MrDemonid/IC-Logic-Tester/Pictures/4a. Start test AP6.jpg

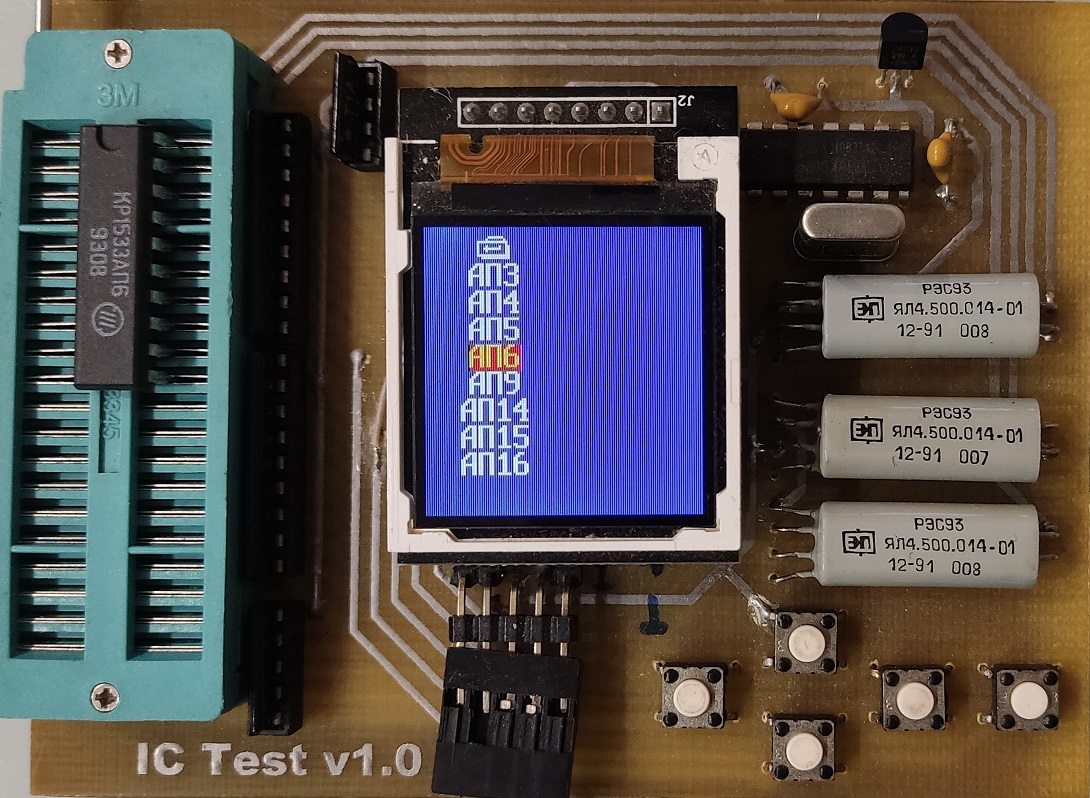
Pictures/4a. Start test AP6.jpg
