MrDemonid/IC-Logic-Tester/Pictures/1. Tester without display.jpg

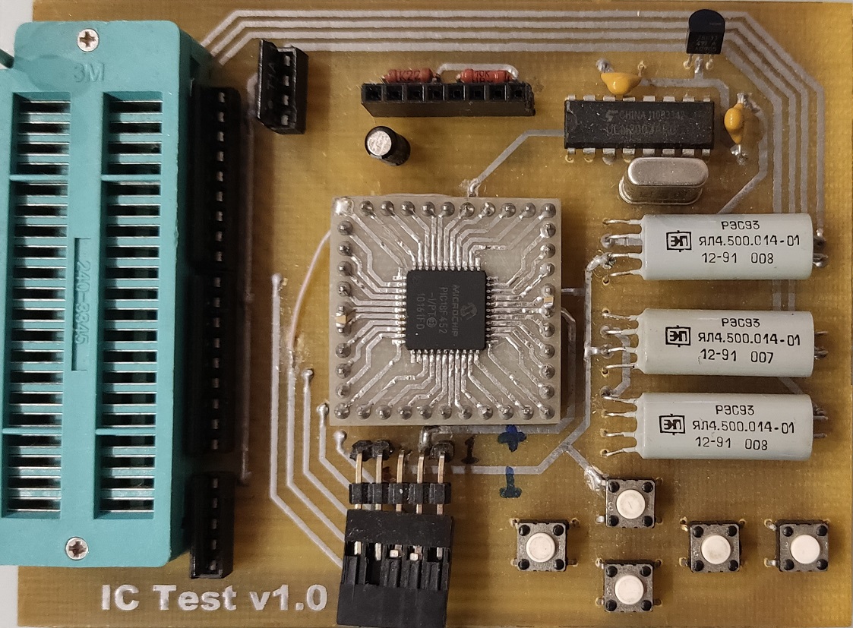
Pictures/1. Tester without display.jpg
