MrDemonid/IC-Logic-Tester/Source/README.TXT

IC tester. Last version.

Протестированные микросхемы:
============================

ТТЛ(Ш)
------
АП3, АП4, АП5, АП6
ИД3, ИД4, ИД7, ИД14
ИЕ2, ИЕ5, ИЕ6, ИЕ7, ИЕ9, ИЕ10, ИЕ18
ИМ3
ИП2, ИП3
ИР9, ИР10, ИР16, ИР22, ИР23, ИР26, ИР27
КП2, КП7, КП11, КП12, КП14, КП15
ЛА1, ЛА2, ЛА3, ЛА4, ЛА6, ЛА7, ЛА8, ЛА13
ЛЕ1, ЛЕ2
ЛИ1, ЛИ3, ЛИ6
ЛЛ1
ЛН1, ЛН3
ЛП5, ЛП8, ЛП11
(!)ЛР1(6), (!)ЛР3(2), ЛР13
РП1 (#)
РУ2
СП1
ТВ1, ТВ9
ТЛ2
ТМ2, ТМ7, ТМ8

----------------------------------------
561
---
ИД1
ИЕ1
ИЕ10
ЛА8
ЛЕ6
ЛИ1
ЛН1
ЛН2
ЛП2
ЛП12
ПР1
ТВ1
ТМ2
ТР2

----------------------------------------
580
---
ВА86  (#)
ИР83  (#)
ИР82

----------------------------------------
589
---
Исключил, поскольку не проходят по току.

===========================================

(!) - выдают ошибки, скорее всего не хватает тока.
(#) - для тестирования требуется к ножке земли микросхемы
      проводком напрямую подключить землю, взяв её, например,
      с 12-го контакта ZIF-панельки (как на фотках).
