MrDemonid/IC-Logic-Tester/Source/NEW/README.TXT

Не успел протестировать, потребность отпала.
