MrDemonid/IC-Logic-Tester/Source/TOOLS/README.TXT

Набор утилит, используемый при создании прошивки тестера.

CUTFNT.
        Конвертация стандартных битовых фонтов 8x8, 8x14 и 8x16 в более 
подходящий формат для микроконтроллера. Запуск без параметров выдаст справку. 
Программа использует функции DOS для выделения и работы с большими блоками 
памяти (200+ Кб), так что не уверен на счет её работы в DosBox. 
В данном случае эта фишка не нужна, просто скорее всего исходник писался на 
основе другого, использующего виртуальный буфер экрана 640x400. За
давностью лет уже не помню, тем более исходники игры безвозвратно утрачены
вместе с дискетой.

ICPARSER.
        Парсит IC-файлы для тестера на AtMega128, товарища Trol'a, и 
конвертирует их под PIC, заодно создавая структуры для меню. Если бы не
его файлы, тестер поддерживал бы очень ограниченный набор микросхем, под
которые он собственно и создавался. 
Сам тестер расположен здесь: https://trolsoft.ru/ru/sch/chip-tester
Парсер писался еще под старую его версию, с монохромных дисплеем, 
когда в нём еще не было даже поддержки DRAM и ПЗУ. Так что
с новыми файлами возможно и не будет работать, не проверял.

LCD.
        Программа на Borland C 3.1, используемая для написания интерфейса.
Отлаживать графически интерфейс прямо на микроконтроллере не очень хорошая 
идея, особенно на старых PIC, где заливка прошивки занимала приличное время,
а ресурс микроконтроллера снижался. Поэтому, графическую часть для МК я всегда
делаю на компьютере, в своеобразном "эмуляторе". А поскольку заморачитваться с 
WIN GUI не хочется, предпочитаю делать это в старом-добром DOS, где работа
с графикой легка и понятна, а самое главное - если программа глючит, то 
это не списать, по привычке, на товарища Билла и его форточки, а нужно искать 
ошибку у себя :)
