MrDemonid/IC-Logic-Tester/Pictures/2. Side back.jpg

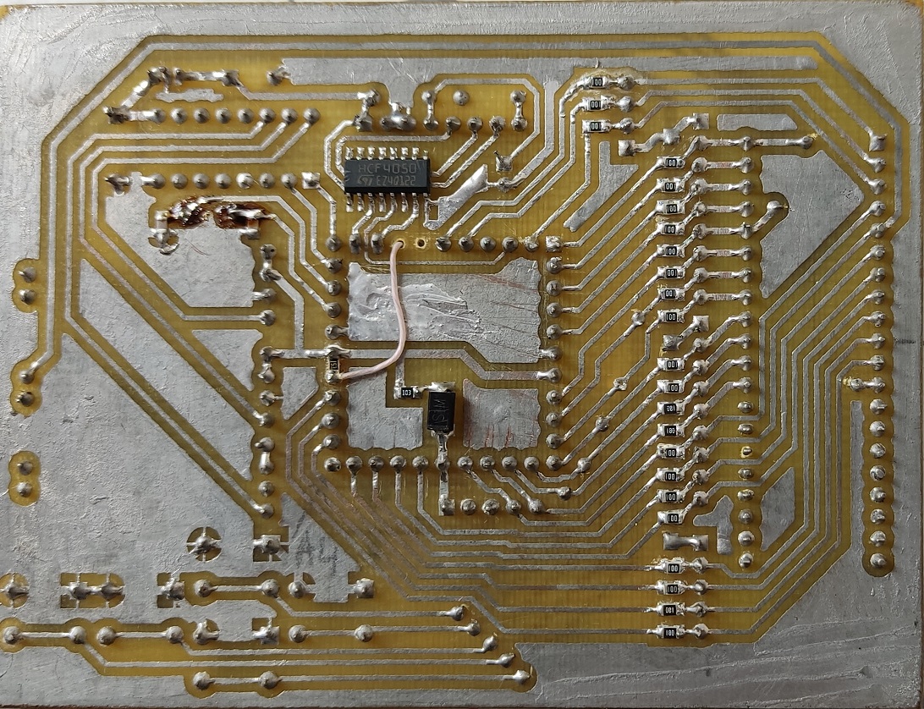
Pictures/2. Side back.jpg
