MrDemonid/IC-Logic-Tester/Pictures/3. Ready.jpg

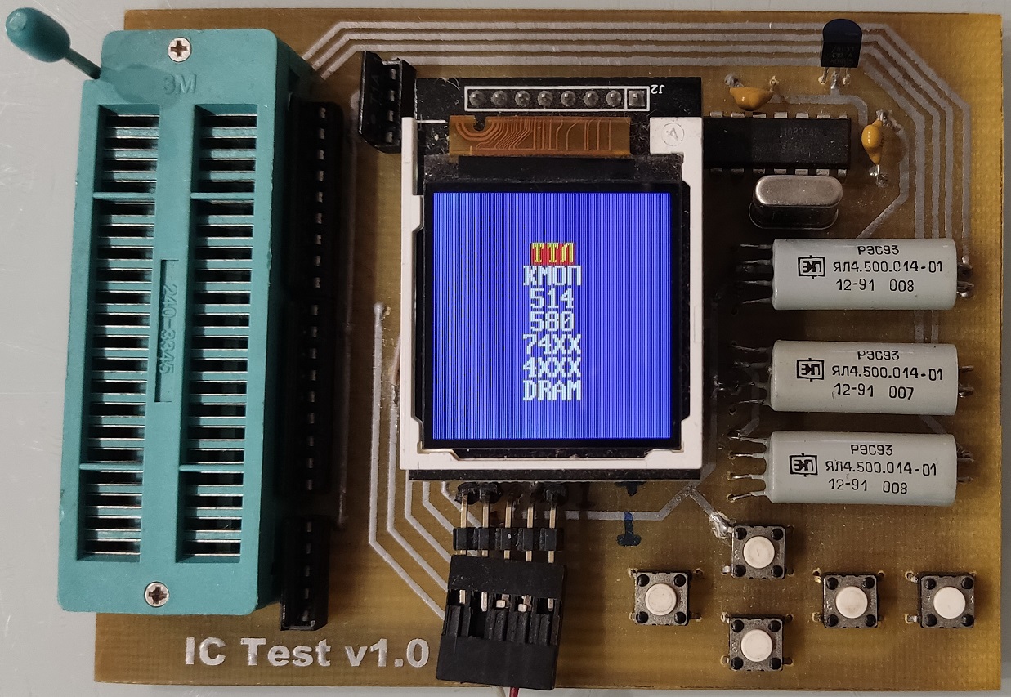
Pictures/3. Ready.jpg
