MrDemonid/IC-Logic-Tester/Pictures/5b. DRAM RU7 is Bad cells.jpg

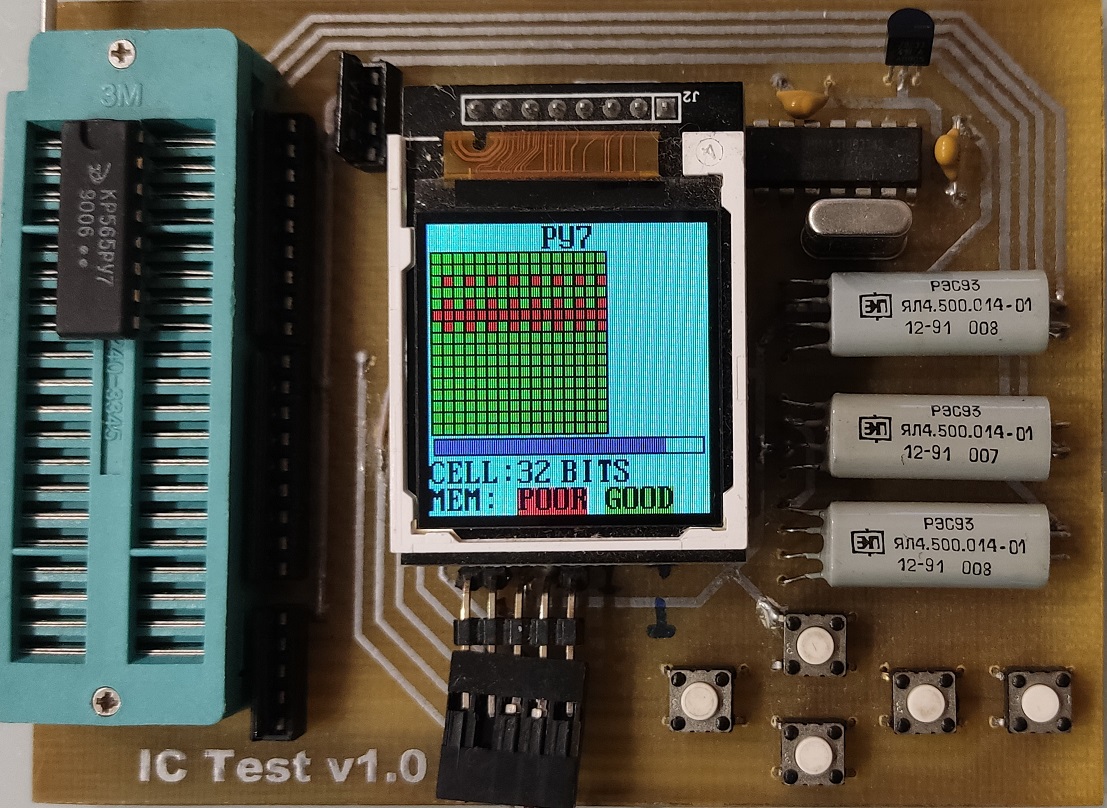
Pictures/5b. DRAM RU7 is Bad cells.jpg
