MrDemonid/IC-Logic-Tester/Pictures/6a. 580VA86.jpg

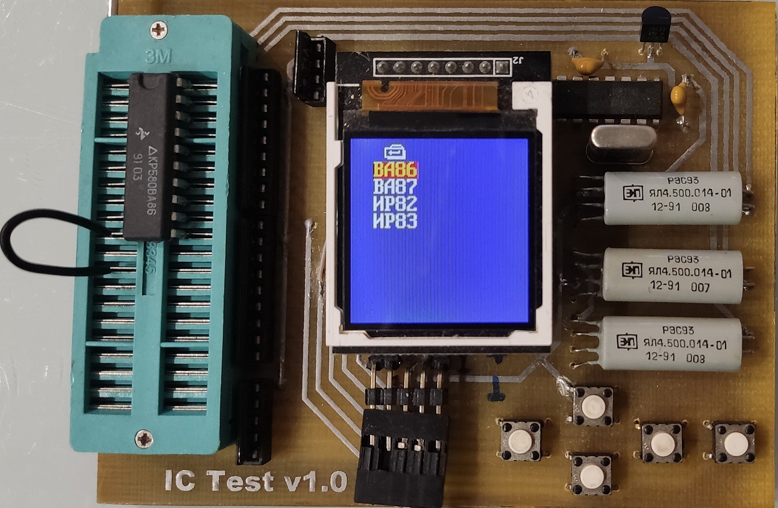
Pictures/6a. 580VA86.jpg
