MrDemonid/IC-Logic-Tester/Pictures/6c. 580VA86 without jumper to GND.jpg

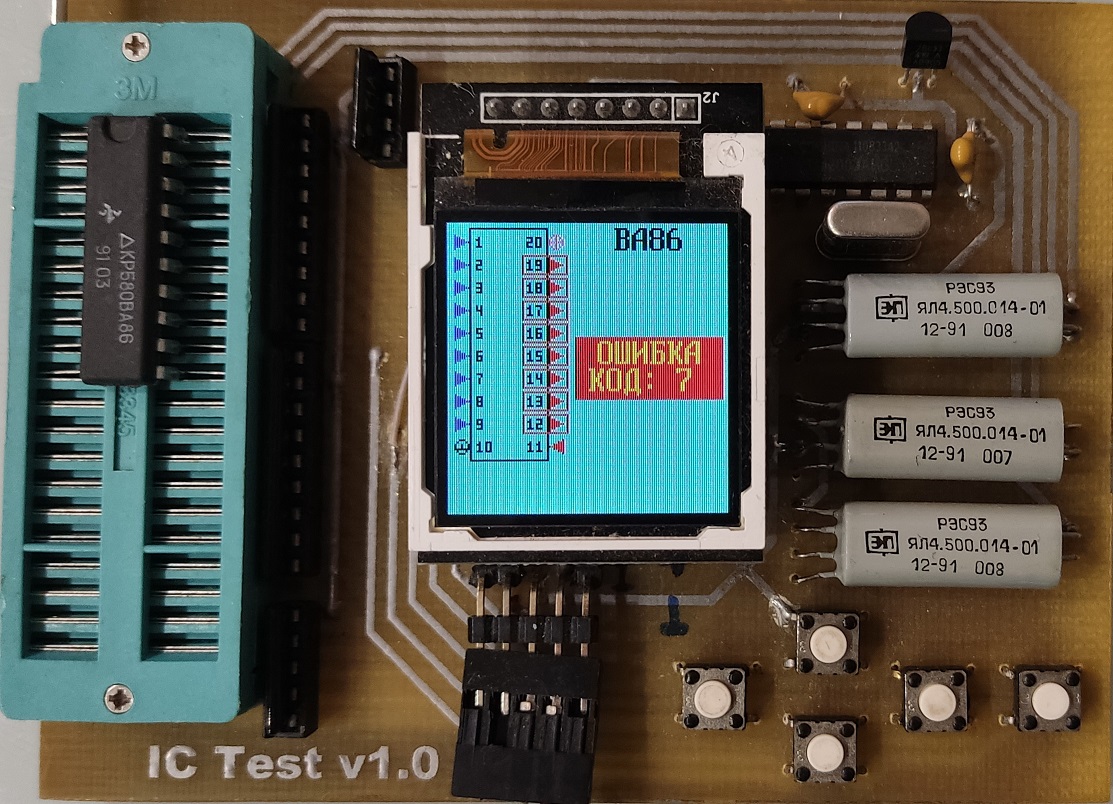
Pictures/6c. 580VA86 without jumper to GND.jpg
