MrDemonid/IC-Logic-Tester/Pictures/7a. 580IR83 with jumper to GND.jpg

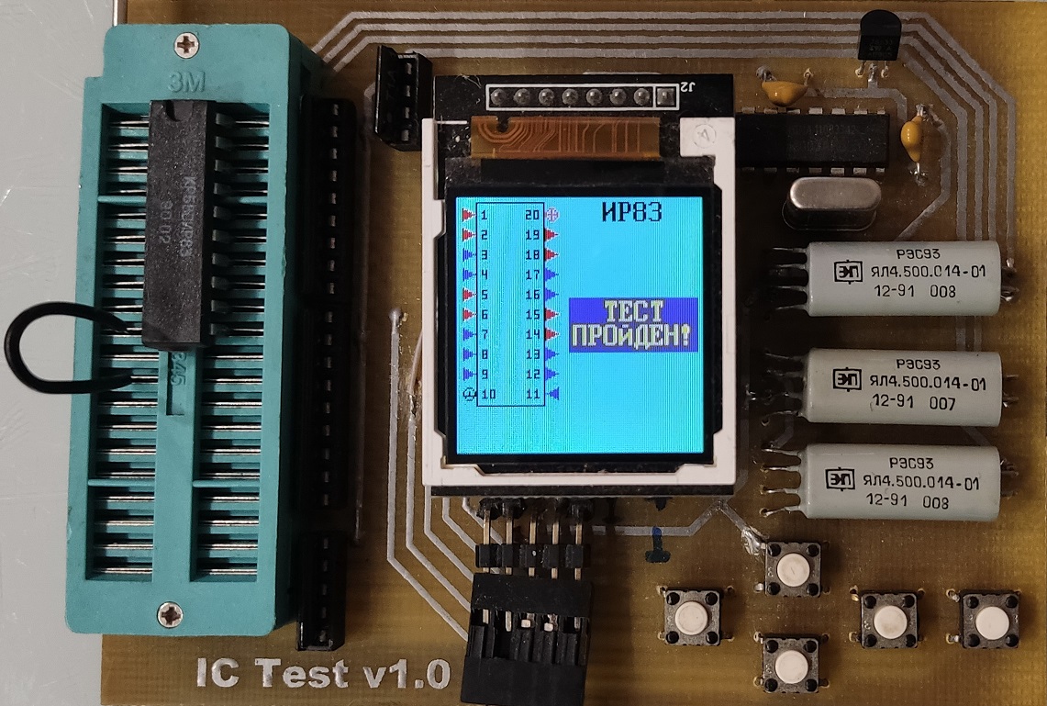
Pictures/7a. 580IR83 with jumper to GND.jpg
