MrDemonid/IC-Logic-Tester/Pcb/IC Tester (Sheme).pdf

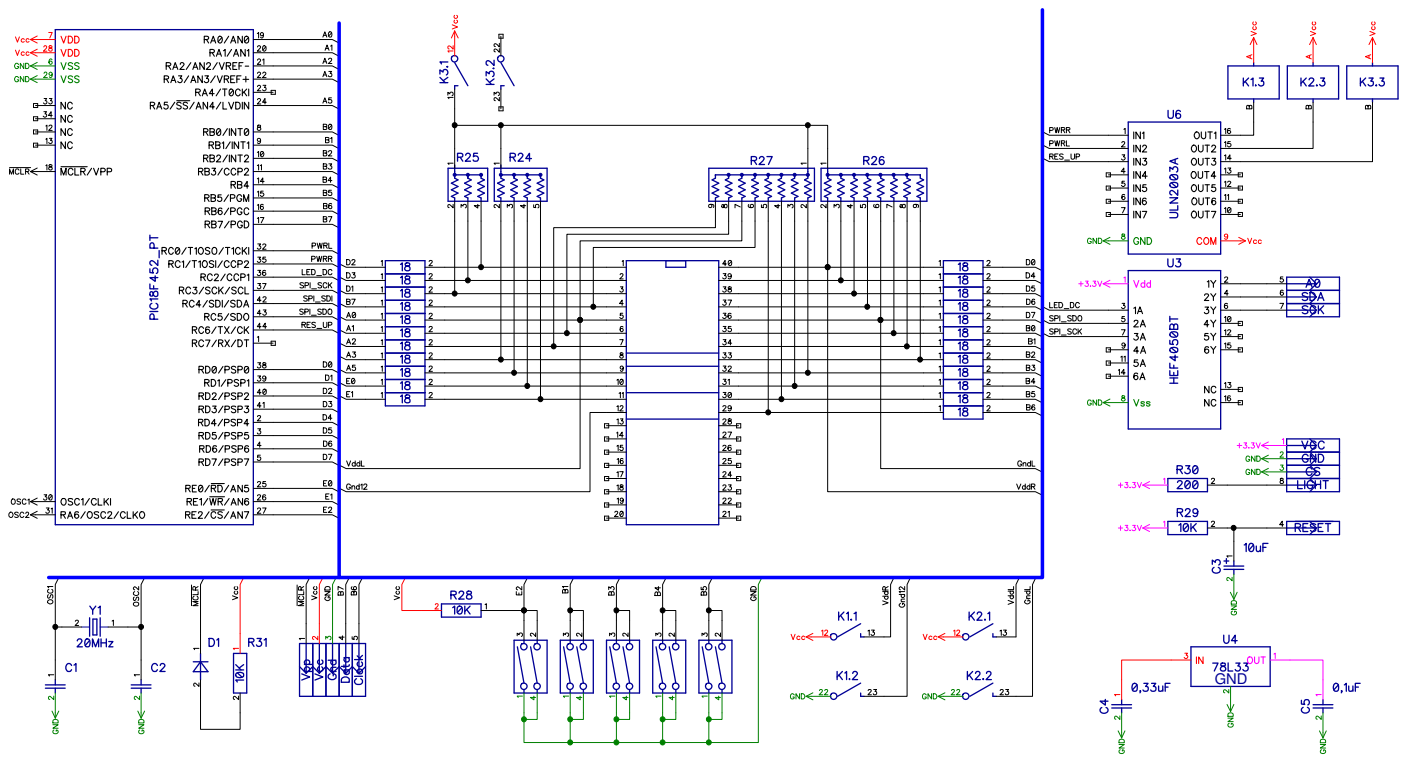
[picture p9: page 1]
GND
