MrDemonid/IC-Logic-Tester/Pcb/IC Tester (bottom 600 dpi).pdf

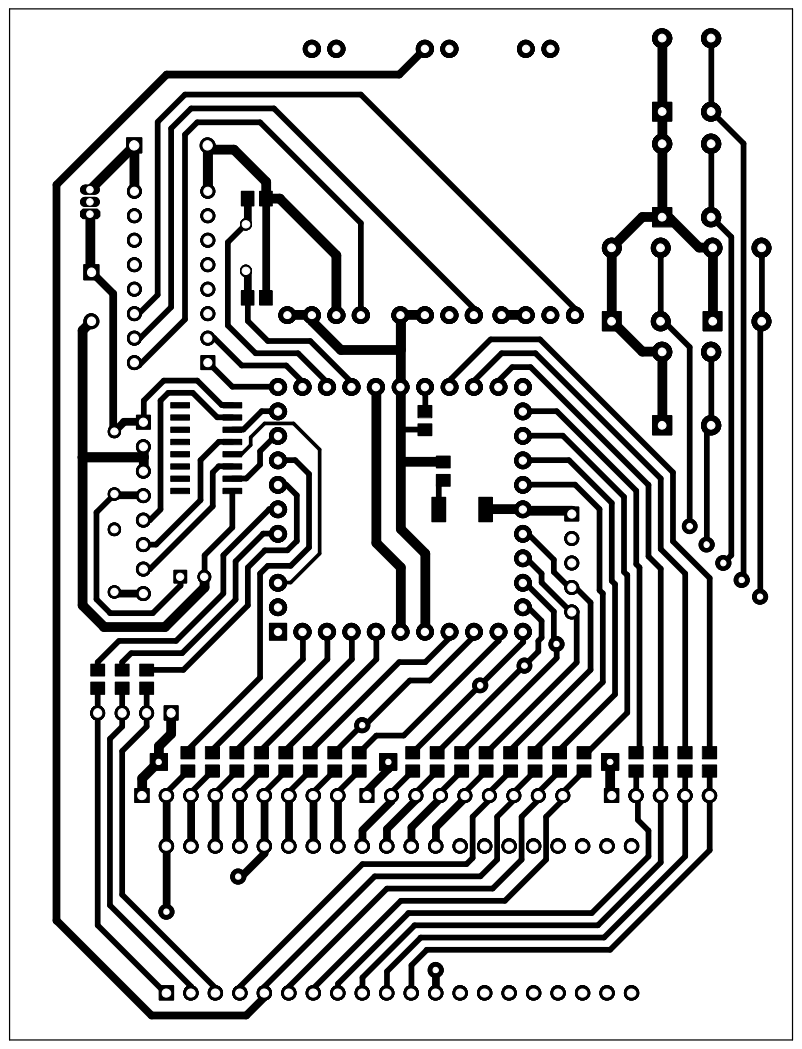
[picture p10: page 1]
