MrDemonid/IC-Logic-Tester/Pcb/IC Tester (top 600 dpi).pdf

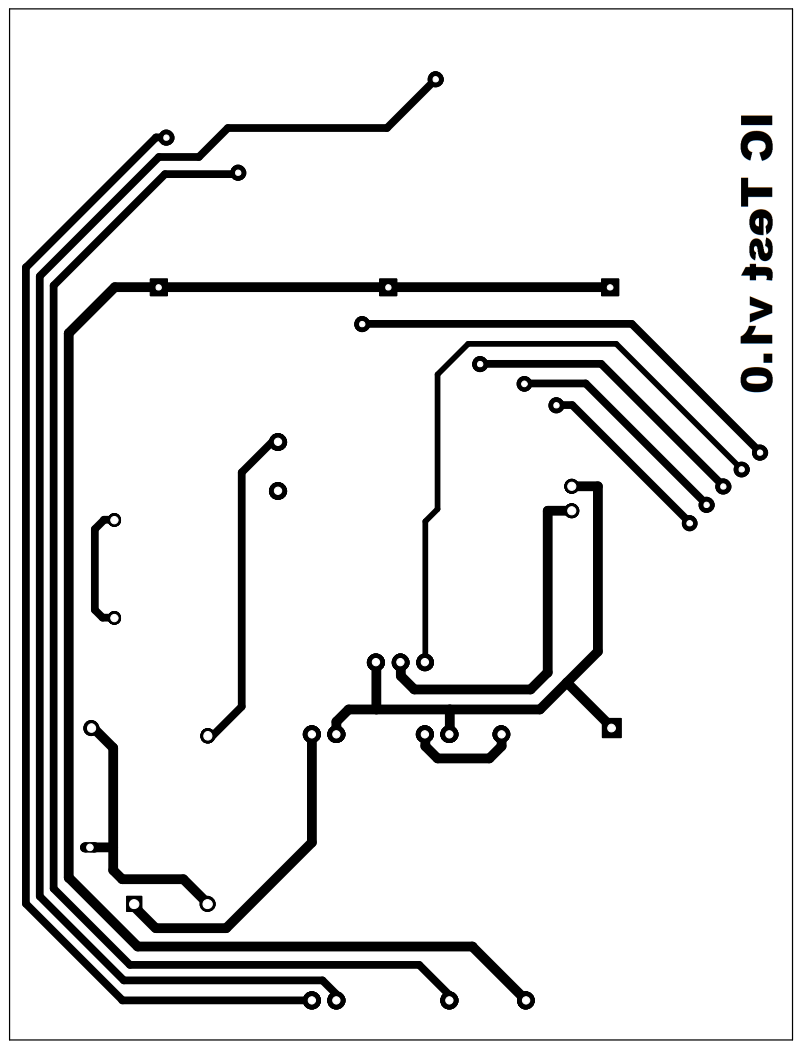
[picture p11: page 1]
