MrDemonid/IC-Logic-Tester/(list of files, drawings)

Other design files:
Pcb/IC Tester.dch
Pcb/IC Tester.dip
