MrDemonid/IC-Logic-Tester/Source/580DATA.H

const char xlab0000[] = { // ÂÀ87
CMD_INIT_20, 0b11111111, 0b00000111, 0b00001000, 
CMD_SET_ALL, 0b10101010, 0b00000101, 0b00000000, 
CMD_PULLUP,
CMD_TEST_ALL, 0b00000000, 0b11111000, 0b00000111, 
CMD_SET_ALL_AND_TEST, 0b10101010, 0b00000101, 0b00000000, 0b00000000, 0b11111000, 0b00000111, 
CMD_SET_ALL_AND_TEST, 0b01010101, 0b00000101, 0b00000000, 0b00000000, 0b11111000, 0b00000111, 
CMD_PULLDN,
CMD_SET_ALL_AND_TEST, 0b00000000, 0b00000100, 0b00000000, 0b00000000, 0b11111000, 0b00000111, 
CMD_SET_ALL_AND_TEST, 0b00000001, 0b00000100, 0b00000000, 0b00000000, 0b11111000, 0b00000011, 
CMD_SET_ALL_AND_TEST, 0b00000010, 0b00000100, 0b00000000, 0b00000000, 0b11111000, 0b00000101, 
CMD_SET_ALL_AND_TEST, 0b00000100, 0b00000100, 0b00000000, 0b00000000, 0b11111000, 0b00000110, 
CMD_SET_ALL_AND_TEST, 0b00001000, 0b00000100, 0b00000000, 0b00000000, 0b01111000, 0b00000111, 
CMD_SET_ALL_AND_TEST, 0b00010000, 0b00000100, 0b00000000, 0b00000000, 0b10111000, 0b00000111, 
CMD_SET_ALL_AND_TEST, 0b00100000, 0b00000100, 0b00000000, 0b00000000, 0b11011000, 0b00000111, 
CMD_SET_ALL_AND_TEST, 0b01000000, 0b00000100, 0b00000000, 0b00000000, 0b11101000, 0b00000111, 
CMD_SET_ALL_AND_TEST, 0b10000000, 0b00000100, 0b00000000, 0b00000000, 0b11110000, 0b00000111, 
CMD_SET_ALL_AND_TEST, 0b11111111, 0b00000100, 0b00000000, 0b00000000, 0b00000000, 0b00000000, 
CMD_SET_ALL_AND_TEST, 0b11111110, 0b00000100, 0b00000000, 0b00000000, 0b00000000, 0b00000100, 
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
CMD_SET_ALL_AND_TEST, 0b11001100, 0b00000100, 0b00000000, 0b00000000, 0b10011000, 0b00000001, 
CMD_SET_TO_0, 11, 
CMD_SET_ALL_AND_TEST, 0b00110011, 0b00000000, 0b00000000, 0b00000000, 0b10011000, 0b00000001, 
CMD_END };
