MrDemonid/IC-Logic-Tester/Source/CMOSDATA.H

const char clab0000[] = { // ÏÐ1(HC4094)
CMD_INIT_16, 0b10000111, 0b11000000, 
CMD_SET_ALL, 0b00000000, 0b00000000, 
CMD_PULSE, 3, 
CMD_LAST_REPEAT_PULSE, 7, 
CMD_SET_ALL_AND_TEST, 0b00000001, 0b01000000, 0b00000000, 0b00000000, 
CMD_SET_TO_1, 2, 
CMD_LAST_PULSE_AND_TEST, 0b00001000, 0b00000000, 
CMD_LAST_PULSE_AND_TEST, 0b00011000, 0b00000000, 
CMD_LAST_PULSE_AND_TEST, 0b00111000, 0b00000000, 
CMD_LAST_PULSE_AND_TEST, 0b01111000, 0b00000000, 
CMD_LAST_PULSE_AND_TEST, 0b01111000, 0b00100000, 
CMD_LAST_PULSE_AND_TEST, 0b01111000, 0b00110000, 
CMD_LAST_PULSE_AND_TEST, 0b01111000, 0b00111000, 
CMD_LAST_PULSE_AND_TEST, 0b01111000, 0b00111101, 
CMD_SET_TO_0, 3, 
CMD_TEST_ALL, 0b01111000, 0b00111111, 
CMD_SET_TO_0, 2, 
CMD_LAST_PULSE_AND_TEST, 0b01110000, 0b00111111, 
CMD_LAST_PULSE_AND_TEST, 0b01100000, 0b00111111, 
CMD_LAST_PULSE_AND_TEST, 0b01000000, 0b00111111, 
CMD_LAST_PULSE_AND_TEST, 0b00000000, 0b00111111, 
CMD_LAST_PULSE_AND_TEST, 0b00000000, 0b00011111, 
CMD_LAST_PULSE_AND_TEST, 0b00000000, 0b00001111, 
CMD_LAST_PULSE_AND_TEST, 0b00000000, 0b00000111, 
CMD_LAST_PULSE_AND_TEST, 0b00000000, 0b00000010, 
CMD_SET_TO_0, 3, 
CMD_TEST_ALL, 0b00000000, 0b00000000, 
CMD_SET_TO_0, 15, 
CMD_PULLUP,
CMD_TEST_ALL, 0b01111000, 0b00111100, 
CMD_END };
const char clab0001[] = { // ÈÅ1(CD4028)
CMD_INIT_14, 0b11100011, 0b00110001, 
CMD_SET_ALL_AND_TEST, 0b00000001, 0b00010000, 0b00000000, 0b00000000, 
CMD_SET_TO_0, 13, 
CMD_PULSE, -1, 
CMD_TEST_ALL, 0b00000100, 0b00000000, 
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
CMD_SET_ALL_AND_TEST, 0b00100000, 0b00000000, 0b00010010, 0b00100101, 
CMD_SET_ALL_AND_TEST, 0b00000000, 0b00000010, 0b01010010, 0b00100100, 
CMD_SET_ALL_AND_TEST, 0b00000000, 0b00010000, 0b01010010, 0b00100001, 
CMD_SET_ALL_AND_TEST, 0b00000000, 0b01000000, 0b01010010, 0b00000101, 
CMD_SET_ALL_AND_TEST, 0b00100001, 0b00010000, 0b00010000, 0b00100001, 
CMD_SET_ALL_AND_TEST, 0b00000100, 0b01000010, 0b01000010, 0b00000100, 
CMD_SET_ALL_AND_TEST, 0b00100101, 0b01010010, 0b00000000, 0b00000000, 
CMD_PULLUP,
CMD_SET_ALL_AND_TEST, 0b00100101, 0b01011010, 0b00000000, 0b00000000, 
CMD_SET_ALL_AND_TEST, 0b00000000, 0b00001000, 0b00000000, 0b00000000, 
CMD_SET_ALL_AND_TEST, 0b00100001, 0b00011000, 0b00000000, 0b00000000, 
CMD_SET_ALL_AND_TEST, 0b00000100, 0b01001010, 0b00000000, 0b00000000, 
CMD_SET_ALL_AND_TEST, 0b00101101, 0b01010010, 0b01010010, 0b00100101, 
CMD_SET_ALL_AND_TEST, 0b00001000, 0b00000000, 0b01010010, 0b00100101, 
CMD_SET_ALL_AND_TEST, 0b00101001, 0b00010000, 0b01010010, 0b00100101, 
CMD_SET_ALL_AND_TEST, 0b00001100, 0b01000010, 0b01010010, 0b00100101, 
CMD_END };
