MrDemonid/IC-Logic-Tester/Source/TTLDATA.H

const char tlab0000[] = { // ÈÏ3(181)
CMD_INIT_24|FL_OC, 0b11111111, 0b00001000, 0b11111110, 
CMD_SET_ALL_AND_TEST, 0b01001000, 0b00000000, 0b00000000, 0b00000000, 0b10000000, 0b00000000, 
CMD_SET_ALL_AND_TEST, 0b01001001, 0b00000000, 0b01101110, 0b00000000, 0b10010010, 0b00000000, 
CMD_END };
const char tlab0001[] = { // ÀÏ16(643)
CMD_INIT_20, 0b11111111, 0b00000011, 0b00001100, 
CMD_SET_ALL_AND_TEST, 0b11111111, 0b00000001, 0b00000000, 0b00000000, 0b00000000, 0b00000000, 
CMD_SET_ALL_AND_TEST, 0b00000001, 0b00000000, 0b00000000, 0b00000000, 0b11111100, 0b00000011, 
CMD_SET_ALL_AND_TEST, 0b01010101, 0b00000001, 0b00000000, 0b00000000, 0b10101000, 0b00000010, 
CMD_SET_ALL_AND_TEST, 0b10101011, 0b00000000, 0b00000000, 0b00000000, 0b01010100, 0b00000001, 
CMD_SET_ALL_AND_TEST, 0b00000001, 0b00000001, 0b00000000, 0b00000000, 0b11111000, 0b00000011, 
CMD_SET_ALL_AND_TEST, 0b10000001, 0b00000000, 0b00000000, 0b00000000, 0b11110100, 0b00000011, 
CMD_SET_ALL_AND_TEST, 0b01000001, 0b00000000, 0b00000000, 0b00000000, 0b11101100, 0b00000011, 
CMD_SET_ALL_AND_TEST, 0b00100001, 0b00000000, 0b00000000, 0b00000000, 0b11011100, 0b00000011, 
CMD_SET_ALL_AND_TEST, 0b00010001, 0b00000000, 0b00000000, 0b00000000, 0b10111100, 0b00000011, 
CMD_SET_ALL_AND_TEST, 0b00001001, 0b00000000, 0b00000000, 0b00000000, 0b01111100, 0b00000011, 
CMD_SET_ALL_AND_TEST, 0b00000101, 0b00000000, 0b00000000, 0b00000000, 0b11111100, 0b00000010, 
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
CMD_LAST_PULSE_AND_TEST, 0b01100000, 0b00000011, 
CMD_SET_ALL, 0b00011000, 0b01111000, 
CMD_LAST_PULSE_AND_TEST, 0b00000000, 0b00000010, 
CMD_SET_ALL, 0b00011001, 0b00111000, 
CMD_LAST_PULSE_AND_TEST, 0b00000000, 0b00000001, 
CMD_SET_ALL, 0b00011010, 0b00111000, 
CMD_LAST_PULSE_AND_TEST, 0b01000000, 0b00000000, 
CMD_SET_ALL, 0b00011100, 0b00111000, 
CMD_LAST_PULSE_AND_TEST, 0b00100000, 0b00000000, 
CMD_SET_ALL, 0b00011000, 0b00111000, 
CMD_LAST_PULSE_AND_TEST, 0b00000000, 0b00000000, 
CMD_SET_ALL, 0b00011111, 0b01111000, 
CMD_LAST_PULSE_AND_TEST, 0b01100000, 0b00000011, 
CMD_END };
const char tlab006F[] = { // ÈÐ26(670)
CMD_INIT_16, 0b10011111, 0b11111100, 
CMD_SET_ALL, 0b00000000, 0b00001000, 
CMD_PULSE, -12, 
CMD_TEST_ALL, 0b00000000, 0b00000000, 
CMD_SET_ALL, 0b00000000, 0b01001000, 
CMD_LAST_PULSE_AND_TEST, 0b00000000, 0b00000010, 
CMD_SET_ALL, 0b00000001, 0b00001000, 
CMD_LAST_PULSE_AND_TEST, 0b00000000, 0b00000001, 
CMD_SET_ALL, 0b00000010, 0b00001000, 
CMD_LAST_PULSE_AND_TEST, 0b01000000, 0b00000000, 
CMD_SET_ALL, 0b00000100, 0b00001000, 
CMD_LAST_PULSE_AND_TEST, 0b00100000, 0b00000000, 
CMD_SET_ALL, 0b00000111, 0b01001000, 
CMD_LAST_PULSE_AND_TEST, 0b01100000, 0b00000011, 
CMD_SET_ALL, 0b00001000, 0b00011000,
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
