MrDemonid/IC-Logic-Tester/Source/8X12.H

#define FONT_WIDTH  8
#define FONT_HEIGHT 12
const char Fnt8x12[] = {
    0x00,0x00,0x00,0x00,0x00,0x00,0x00,0x00,0x00,0x00,0x00,0x00,
    0x30,0x78,0x78,0x78,0x30,0x30,0x30,0x00,0x30,0x30,0x00,0x00,
    0x66,0x66,0x22,0x22,0x00,0x00,0x00,0x00,0x00,0x00,0x00,0x00,
    0x07,0x08,0xFF,0x80,0x88,0x9F,0x88,0x80,0xFF,0x3F,0x00,0x00,
    0xF0,0x08,0xFC,0x04,0x26,0xE6,0x06,0x06,0xFE,0xFE,0x00,0x00,
    0x00,0x3E,0x40,0x40,0x3E,0x00,0x7E,0x12,0x12,0x0C,0x00,0x00,
    0x38,0x6C,0x6C,0x38,0x30,0x76,0xDC,0xCC,0xCC,0x76,0x00,0x00,
    0x30,0x30,0x30,0x60,0x00,0x00,0x00,0x00,0x00,0x00,0x00,0x00,
    0x0C,0x18,0x30,0x30,0x30,0x30,0x30,0x30,0x18,0x0C,0x00,0x00,
    0x30,0x18,0x0C,0x0C,0x0C,0x0C,0x0C,0x0C,0x18,0x30,0x00,0x00,
    0x00,0x00,0x00,0x66,0x3C,0xFF,0x3C,0x66,0x00,0x00,0x00,0x00,
    0x00,0x00,0x00,0x18,0x18,0x7E,0x18,0x18,0x00,0x00,0x00,0x00,
    0x00,0x00,0x00,0x00,0x00,0x00,0x00,0x00,0x18,0x18,0x18,0x30,
    0x00,0x00,0x00,0x00,0x00,0xFE,0x00,0x00,0x00,0x00,0x00,0x00,
    0x00,0x00,0x00,0x00,0x00,0x00,0x00,0x00,0x18,0x18,0x00,0x00,
    0xEE,0xA8,0xA8,0xA8,0xEE,0x00,0xFE,0x00,0x00,0x00,0x00,0x00,
    0x7C,0xC6,0xC6,0xCE,0xD6,0xE6,0xC6,0xC6,0xC6,0x7C,0x00,0x00,
    0x18,0x38,0x78,0x18,0x18,0x18,0x18,0x18,0x18,0x7E,0x00,0x00,
    0x7C,0xC6,0x06,0x0C,0x18,0x30,0x60,0xC0,0xC6,0xFE,0x00,0x00,
    0x7C,0xC6,0x06,0x06,0x3C,0x06,0x06,0x06,0xC6,0x7C,0x00,0x00,
    0x0C,0x1C,0x3C,0x6C,0xCC,0xFE,0x0C,0x0C,0x0C,0x1E,0x00,0x00,
    0xFE,0xC0,0xC0,0xC0,0xFC,0x06,0x06,0x06,0xC6,0x7C,0x00,0x00,
    0x38,0x60,0xC0,0xC0,0xFC,0xC6,0xC6,0xC6,0xC6,0x7C,0x00,0x00,
    0xFE,0xC6,0x06,0x06,0x0C,0x18,0x30,0x30,0x30,0x30,0x00,0x00,
    0x7C,0xC6,0xC6,0xC6,0x7C,0xC6,0xC6,0xC6,0xC6,0x7C,0x00,0x00,
    0x7C,0xC6,0xC6,0xC6,0x7E,0x06,0x06,0x06,0x0C,0x78,0x00,0x00,
    0x00,0x00,0x18,0x18,0x00,0x00,0x00,0x18,0x18,0x00,0x00,0x00,
    0x00,0x00,0x18,0x18,0x00,0x00,0x00,0x18,0x18,0x30,0x00,0x00,
    0x00,0x06,0x0C,0x18,0x30,0x60,0x30,0x18,0x0C,0x06,0x00,0x00,
    0x00,0x00,0x00,0x7E,0x00,0x00,0x7E,0x00,0x00,0x00,0x00,0x00,
    0x00,0x60,0x30,0x18,0x0C,0x06,0x0C,0x18,0x30,0x60,0x00,0x00,
    0x7C,0xC6,0xC6,0x0C,0x18,0x18,0x18,0x00,0x18,0x18,0x00,0x00,
    0x00,0x38,0x44,0x9A,0xAA,0xAA,0xAA,0x9C,0x40,0x3C,0x00,0x00,
    0x10,0x38,0x6C,0xC6,0xC6,0xFE,0xC6,0xC6,0xC6,0xC6,0x00,0x00,
    0xFC,0x66,0x66,0x66,0x7C,0x66,0x66,0x66,0x66,0xFC,0x00,0x00,
    0x3C,0x66,0xC2,0xC0,0xC0,0xC0,0xC0,0xC2,0x66,0x3C,0x00,0x00,
    0xF8,0x6C,0x66,0x66,0x66,0x66,0x66,0x66,0x6C,0xF8,0x00,0x00,
    0xFE,0x66,0x62,0x68,0x78,0x68,0x60,0x62,0x66,0xFE,0x00,0x00,
    0xFE,0x66,0x62,0x68,0x78,0x68,0x60,0x60,0x60,0xF0,0x00,0x00,
    0x3C,0x66,0xC2,0xC0,0xC0,0xDE,0xC6,0xC6,0x66,0x3A,0x00,0x00,
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
};
