MrDemonid/IC-Logic-Tester/Source/CMOSMENU.H

#define clenID    3
#define clenIE    7
#define clenIR    2
#define clenKT    3
#define clenLA    4
#define clenLE    4
#define clenLI    2
#define clenLN    4
#define clenLP    3
#define clenLS    2
#define clenPR    2
#define clenPU    2
#define clenTV    2
#define clenTL    2
#define clenTM    2
#define clenTR    2
#define clenCMOS    17
const char * const clabID[] = { 0,clab0004,clab0005 };
const char * const clabIE[] = { 0,clab0001,clab0015,clab0016,clab0002,clab0018,clab0017 };
const char * const clabIR[] = { 0,clab0003 };
const char * const clabKT[] = { 0,clab0006,clab0006 };
const char * const clabLA[] = { 0,clab0010,clab0011,clab0012 };
const char * const clabLE[] = { 0,clab0019,clab000E,clab000F };
const char * const clabLI[] = { 0,clab0009 };
const char * const clabLN[] = { 0,clab001A,clab000C,clab000D };
const char * const clabLP[] = { 0,clab0007,clab0008 };
const char * const clabLS[] = { 0,clab0014 };
const char * const clabPR[] = { 0,clab0000 };
const char * const clabPU[] = { 0,clab000C };
const char * const clabTV[] = { 0,clab000B };
const char * const clabTL[] = { 0,clab0010 };
const char * const clabTM[] = { 0,clab0013 };
const char * const clabTR[] = { 0,clab000A };
const char * const citemID[] = { "#$","ÈÄ1","ÈÄ2" };
const char * const citemIE[] = { "#$","ÈÅ1","ÈÅ3","ÈÅ4","ÈÅ8","ÈÅ10","ÈÅ11" };
const char * const citemIR[] = { "#$","ÈÐ2" };
const char * const citemKT[] = { "#$","ÊÒ1","ÊÒ3" };
const char * const citemLA[] = { "#$","ËÀ7","ËÀ8","ËÀ9" };
const char * const citemLE[] = { "#$","ËÅ5","ËÅ6","ËÅ10" };
const char * const citemLI[] = { "#$","ËÈ1" };
const char * const citemLN[] = { "#$","ËÍ1","ËÍ2","ËÍ3" };
const char * const citemLP[] = { "#$","ËÏ2","ËÏ12" };
const char * const citemLS[] = { "#$","ËÑ2" };
const char * const citemPR[] = { "#$","ÏÐ1" };
const char * const citemPU[] = { "#$","ÏÓ7" };
const char * const citemTV[] = { "#$","ÒÂ1" };
const char * const citemTL[] = { "#$","ÒË1" };
const char * const citemTM[] = { "#$","ÒÌ2" };
const char * const citemTR[] = { "#$","ÒÐ2" };
const MENU cmnuID = { citemID, 0x80, clenID, (MENU **) clabID };
const MENU cmnuIE = { citemIE, 0x80, clenIE, (MENU **) clabIE };
const MENU cmnuIR = { citemIR, 0x80, clenIR, (MENU **) clabIR };
const MENU cmnuKT = { citemKT, 0x80, clenKT, (MENU **) clabKT };
const MENU cmnuLA = { citemLA, 0x80, clenLA, (MENU **) clabLA };
const MENU cmnuLE = { citemLE, 0x80, clenLE, (MENU **) clabLE };
const MENU cmnuLI = { citemLI, 0x80, clenLI, (MENU **) clabLI };
const MENU cmnuLN = { citemLN, 0x80, clenLN, (MENU **) clabLN };
const MENU cmnuLP = { citemLP, 0x80, clenLP, (MENU **) clabLP };
const MENU cmnuLS = { citemLS, 0x80, clenLS, (MENU **) clabLS };
const MENU cmnuPR = { citemPR, 0x80, clenPR, (MENU **) clabPR };
const MENU cmnuPU = { citemPU, 0x80, clenPU, (MENU **) clabPU };
const MENU cmnuTV = { citemTV, 0x80, clenTV, (MENU **) clabTV };
const MENU cmnuTL = { citemTL, 0x80, clenTL, (MENU **) clabTL };
const MENU cmnuTM = { citemTM, 0x80, clenTM, (MENU **) clabTM };
const MENU cmnuTR = { citemTR, 0x80, clenTR, (MENU **) clabTR };
const char * const citemCMOS[] = { "#$","ÈÄ","ÈÅ","ÈÐ","ÊÒ","ËÀ","ËÅ","ËÈ","ËÍ","ËÏ","ËÑ","ÏÐ","ÏÓ","ÒÂ","ÒË","ÒÌ","ÒÐ"};
const MENU * const clabCMOS[] = { 0,&cmnuID,&cmnuIE,&cmnuIR,&cmnuKT,&cmnuLA,&cmnuLE,&cmnuLI,&cmnuLN,&cmnuLP,&cmnuLS,&cmnuPR,&cmnuPU,&cmnuTV,&cmnuTL,&cmnuTM,&cmnuTR};
const MENU mnuCMOS = { citemCMOS, 0, clenCMOS, clabCMOS  };
