MrDemonid/IC-Logic-Tester/Source/40MENU.H

#define clen4000_4499    21
#define clen4500_9000    5
#define clen4XXX    3
const char * const clab4000_4499[] = { 0,clab0019,clab000E,clab0010,clab0011,clab0013,clab0003,clab0006,clab0002,clab0014,clab0012,clab000F,clab000B,clab0004,clab0001,clab000A,clab000C,clab0006,clab000C,clab0010,clab0000 };
const char * const clab4500_9000[] = { 0,clab001A,clab000D,clab0017,clab0018 };
const char * const citem4000_4499[] = { "#$","4001","4002","4011","4012","4013","4015","4016","4017","4019","4023","4025","4027","4028","4028","4043","4049","4066","4069","4093","4094" };
const char * const citem4500_9000[] = { "#$","4502","4503","4516","4520" };
const MENU cmnu4000_4499 = { citem4000_4499, 0x80, clen4000_4499, (MENU **) clab4000_4499 };
const MENU cmnu4500_9000 = { citem4500_9000, 0x80, clen4500_9000, (MENU **) clab4500_9000 };
const char * const citem4XXX[] = { "#$","4000+","4500+"};
const MENU * const clab4XXX[] = { 0,&cmnu4000_4499,&cmnu4500_9000};
const MENU mnu4XXX = { citem4XXX, 0, clen4XXX, clab4XXX  };
