MrDemonid/IC-Logic-Tester/Source/514DATA.H

const char ilab0000[] = { // ÈÄ2
CMD_INIT_14_1|FL_OC, 0b00111111, 0b00100000, 
CMD_SET_ALL_AND_TEST, 0b00001000, 0b00000000, 0b11000000, 0b00011111, 
CMD_SET_TO_1, 3, 
CMD_TEST_ALL, 0b00000000, 0b00000000, 
CMD_SET_ALL_AND_TEST, 0b00000100, 0b00000000, 0b00000000, 0b00001000, 
CMD_SET_ALL_AND_TEST, 0b00010100, 0b00000000, 0b11000000, 0b00011100, 
CMD_SET_ALL_AND_TEST, 0b00000101, 0b00000000, 0b00000000, 0b00010001, 
CMD_SET_ALL_AND_TEST, 0b00010101, 0b00000000, 0b01000000, 0b00010000, 
CMD_SET_ALL_AND_TEST, 0b00000110, 0b00000000, 0b11000000, 0b00000100, 
CMD_SET_ALL_AND_TEST, 0b00010110, 0b00000000, 0b01000000, 0b00000010, 
CMD_SET_ALL_AND_TEST, 0b00000111, 0b00000000, 0b00000000, 0b00000010, 
CMD_SET_ALL_AND_TEST, 0b00010111, 0b00000000, 0b11000000, 0b00011000, 
CMD_SET_ALL_AND_TEST, 0b00001100, 0b00000000, 0b00000000, 0b00000000, 
CMD_SET_ALL_AND_TEST, 0b00011100, 0b00000000, 0b01000000, 0b00000000, 
CMD_SET_ALL_AND_TEST, 0b00001101, 0b00000000, 0b00000000, 0b00010111, 
CMD_SET_ALL_AND_TEST, 0b00011101, 0b00000000, 0b01000000, 0b00010110, 
CMD_SET_ALL_AND_TEST, 0b00001110, 0b00000000, 0b11000000, 0b00000101, 
CMD_SET_ALL_AND_TEST, 0b00011110, 0b00000000, 0b01000000, 0b00000011, 
CMD_SET_ALL_AND_TEST, 0b00001111, 0b00000000, 0b00000000, 0b00000111, 
CMD_SET_ALL_AND_TEST, 0b00011111, 0b00000000, 0b11000000, 0b00011111, 
CMD_END };
const char ilab0001[] = { // ÈÄ1
CMD_INIT_14_1, 0b00111111, 0b00100000, 
CMD_SET_ALL_AND_TEST, 0b00000100, 0b00000000, 0b11000000, 0b00010111, 
CMD_SET_ALL_AND_TEST, 0b00010100, 0b00000000, 0b00000000, 0b00000011, 
CMD_SET_ALL_AND_TEST, 0b00000101, 0b00000000, 0b11000000, 0b00001110, 
CMD_SET_ALL_AND_TEST, 0b00010101, 0b00000000, 0b10000000, 0b00001111, 
CMD_SET_ALL_AND_TEST, 0b00000110, 0b00000000, 0b00000000, 0b00011011, 
CMD_SET_ALL_AND_TEST, 0b00010110, 0b00000000, 0b10000000, 0b00011101, 
CMD_SET_ALL_AND_TEST, 0b00000111, 0b00000000, 0b11000000, 0b00011101, 
CMD_SET_ALL_AND_TEST, 0b00010111, 0b00000000, 0b00000000, 0b00000111, 
CMD_SET_ALL_AND_TEST, 0b00001100, 0b00000000, 0b11000000, 0b00011111, 
CMD_SET_ALL_AND_TEST, 0b00011100, 0b00000000, 0b10000000, 0b00011111, 
CMD_SET_ALL_AND_TEST, 0b00001101, 0b00000000, 0b11000000, 0b00001000, 
CMD_SET_ALL_AND_TEST, 0b00011101, 0b00000000, 0b10000000, 0b00001001, 
CMD_SET_ALL_AND_TEST, 0b00001110, 0b00000000, 0b00000000, 0b00011010, 
CMD_SET_ALL_AND_TEST, 0b00011110, 0b00000000, 0b10000000, 0b00011100, 
CMD_SET_ALL_AND_TEST, 0b00001111, 0b00000000, 0b11000000, 0b00011000, 
CMD_SET_ALL_AND_TEST, 0b00011111, 0b00000000, 0b00000000, 0b00000000, 
CMD_END };
