MrDemonid/IC-Logic-Tester/Source/580MENU.H

#define xlen580  5
const char * const xlab580[] = { 0,xlab0001,xlab0000,xlab0003,xlab0002 };
const char * const xitem580[] = { "#$","ÂÀ86","ÂÀ87","ÈÐ82","ÈÐ83" };
const MENU mnu580 = { xitem580, 0x80, xlen580, (MENU **) xlab580 };
