MrDemonid/IC-Logic-Tester/Source/DRAMMENU.H

const char * const dramlab[] = { 0, dramRU5, dramRU6, dramRU7, dramRU9 };
const char * const dramitem[] = { "#$","ÐÓ5","ÐÓ6","ÐÓ7","ÐÓ9" };
const MENU mnuDRAM = { dramitem, 0x80, 5, (MENU **) dramlab };
