MrDemonid/IC-Logic-Tester/Source/IMG.H

const unsigned char imgPinNo[] = {
    0x40,0xC0,0x40,0x40,0xE0,
    0xE0,0x20,0xE0,0x80,0xE0,
    0xE0,0x20,0xE0,0x20,0xE0,
    0xA0,0xA0,0xE0,0x20,0x20,
    0xE0,0x80,0xE0,0x20,0xE0,
    0xE0,0x80,0xE0,0xA0,0xE0,
    0xE0,0x20,0x40,0x40,0x40,
    0xE0,0xA0,0xE0,0xA0,0xE0,
    0xE0,0xA0,0xE0,0x20,0xE0,
    0x4E,0xCA,0x4A,0x4A,0xEE,
    0x44,0xCC,0x44,0x44,0xEE,
    0x4E,0xC2,0x4E,0x48,0xEE,
    0x4E,0xC2,0x4E,0x42,0xEE,
    0x4A,0xCA,0x4E,0x42,0xE2,
    0x4E,0xC8,0x4E,0x42,0xEE,
    0x4E,0xC8,0x4E,0x4A,0xEE,
    0x4E,0xC2,0x44,0x44,0xE4,
    0x4E,0xCA,0x4E,0x4A,0xEE,
    0x4E,0xCA,0x4E,0x42,0xEE,
    0xEE,0x2A,0xEA,0x8A,0xEE,
    0xE4,0x2C,0xE4,0x84,0xEE,
    0xEE,0x22,0xEE,0x88,0xEE,
    0xEE,0x22,0xEE,0x82,0xEE,
    0xEA,0x2A,0xEE,0x82,0xE2
};

/*
// ->
const unsigned char imgLPin[] = { 0x10,0x18,0x1C,0xFE,0x1C,0x18,0x10 }; // >
const unsigned char imgRPin[] = { 0x10,0x30,0x70,0xFE,0x70,0x30,0x10 }; // <
const unsigned char imgGND[]  = { 0x38,0x44,0x92,0x92,0xFE,0x44,0x38 };
const unsigned char imgPlus[] = { 0x38,0x54,0x92,0xFE,0x92,0x54,0x38 };
*/

// |> width = 7
const unsigned char imgLPin[] = { 0x80,0xE0,0xF8,0xFE,0xF8,0xE0,0x80 }; // >
const unsigned char imgRPin[] = { 0x02,0x0E,0x3E,0xFE,0x3E,0x0E,0x02 }; // <
const unsigned char imgGND[]  = { 0x38,0x44,0x92,0x92,0xFE,0x44,0x38 };
const unsigned char imgPlus[] = { 0x38,0x54,0x92,0xFE,0x92,0x54,0x38 };


/*
// |> width = 8
const unsigned char imgLPin[] = { 0xC0,0xF0,0xFC,0xFF,0xFC,0xF0,0xC0 }; // >
const unsigned char imgRPin[] = { 0x03,0x0F,0x3F,0xFF,0x3F,0x0F,0x03 }; // <
const unsigned char imgGND[]  = { 0x3C,0x42,0x99,0x99,0xFF,0x42,0x3C };
const unsigned char imgPlus[] = { 0x3C,0x5A,0x99,0xFF,0x99,0x5A,0x3C };
*/
