MrDemonid/IC-Logic-Tester/Source/NEW/DRAMMENU.H

const char * const dramlab[] = { 0, dramRU5, dramRU6, dramRU7, dramRU9, dram464, dram4256 };
const char * const dramitem[] = { "#$","ÐÓ5","ÐÓ6","ÐÓ7","ÐÓ9", "53464", "514256" };
const MENU mnuDRAM = { dramitem, 0x80, 7, (MENU **) dramlab };
