MrDemonid/IC-Logic-Tester/Source/TOOLS/LCD/58XDATA.H

const char xlab0000[] = { // 580ÂÀ87
CMD_INIT_20, b11111111, b00000111, b00001000, 
CMD_SET_ALL, b10101010, b00000101, b00000000, 
CMD_PULLUP,
CMD_TEST_ALL, b00000000, b11111000, b00000111, 
CMD_SET_ALL_AND_TEST, b10101010, b00000101, b00000000, b00000000, b11111000, b00000111, 
CMD_SET_ALL_AND_TEST, b01010101, b00000101, b00000000, b00000000, b11111000, b00000111, 
CMD_PULLDN,
CMD_SET_ALL_AND_TEST, b00000000, b00000100, b00000000, b00000000, b11111000, b00000111, 
CMD_SET_ALL_AND_TEST, b00000001, b00000100, b00000000, b00000000, b11111000, b00000011, 
CMD_SET_ALL_AND_TEST, b00000010, b00000100, b00000000, b00000000, b11111000, b00000101, 
CMD_SET_ALL_AND_TEST, b00000100, b00000100, b00000000, b00000000, b11111000, b00000110, 
CMD_SET_ALL_AND_TEST, b00001000, b00000100, b00000000, b00000000, b01111000, b00000111, 
CMD_SET_ALL_AND_TEST, b00010000, b00000100, b00000000, b00000000, b10111000, b00000111, 
CMD_SET_ALL_AND_TEST, b00100000, b00000100, b00000000, b00000000, b11011000, b00000111, 
CMD_SET_ALL_AND_TEST, b01000000, b00000100, b00000000, b00000000, b11101000, b00000111, 
CMD_SET_ALL_AND_TEST, b10000000, b00000100, b00000000, b00000000, b11110000, b00000111, 
CMD_SET_ALL_AND_TEST, b11111111, b00000100, b00000000, b00000000, b00000000, b00000000, 
CMD_SET_ALL_AND_TEST, b11111110, b00000100, b00000000, b00000000, b00000000, b00000100, 
CMD_SET_ALL_AND_TEST, b11111101, b00000100, b00000000, b00000000, b00000000, b00000010, 
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
CMD_SET_ALL_AND_TEST, b00100100, b01010000, b00010010, b00100000, 
CMD_SET_ALL_AND_TEST, b00100100, b01000010, b00010010, b00000100, 
CMD_SET_ALL_AND_TEST, b00100100, b01010010, b00010010, b00100100, 
CMD_SET_ALL_AND_TEST, b00100100, b01010010, b00010010, b00100100, 
CMD_END };
