MrDemonid/IC-Logic-Tester/Source/TOOLS/LCD/CMOSDATA.H

const char clab0000[] = { // ÏÐ1(HC4094)
CMD_INIT_16, b10000111, b11000000, 
CMD_SET_ALL, b00000000, b00000000, 
CMD_PULSE, 3, 
CMD_SET_ALL_AND_TEST, b00000001, b01000000, b00000000, b00000000, 
CMD_SET_TO_1, 2, 
CMD_LAST_PULSE_AND_TEST, b00001000, b00000000, 
CMD_LAST_PULSE_AND_TEST, b00011000, b00000000, 
CMD_LAST_PULSE_AND_TEST, b00111000, b00000000, 
CMD_LAST_PULSE_AND_TEST, b01111000, b00000000, 
CMD_LAST_PULSE_AND_TEST, b01111000, b00100000, 
CMD_LAST_PULSE_AND_TEST, b01111000, b00110000, 
CMD_LAST_PULSE_AND_TEST, b01111000, b00111000, 
CMD_LAST_PULSE_AND_TEST, b01111000, b00111101, 
CMD_SET_TO_0, 3, 
CMD_TEST_ALL, b01111000, b00111111, 
CMD_SET_TO_0, 2, 
CMD_LAST_PULSE_AND_TEST, b01110000, b00111111, 
CMD_LAST_PULSE_AND_TEST, b01100000, b00111111, 
CMD_LAST_PULSE_AND_TEST, b01000000, b00111111, 
CMD_LAST_PULSE_AND_TEST, b00000000, b00111111, 
CMD_LAST_PULSE_AND_TEST, b00000000, b00011111, 
CMD_LAST_PULSE_AND_TEST, b00000000, b00001111, 
CMD_LAST_PULSE_AND_TEST, b00000000, b00000111, 
CMD_LAST_PULSE_AND_TEST, b00000000, b00000010, 
CMD_SET_TO_0, 3, 
CMD_TEST_ALL, b00000000, b00000000, 
CMD_SET_TO_0, 15, 
CMD_PULLUP,
CMD_TEST_ALL, b01111000, b00111100, 
CMD_END };
const char clab0001[] = { // ÈÅ1(CD4028)
CMD_INIT_14, b11100011, b00110001, 
CMD_SET_ALL_AND_TEST, b00000001, b00010000, b00000000, b00000000, 
CMD_SET_TO_0, 13, 
CMD_PULSE, -1, 
CMD_TEST_ALL, b00000100, b00000000, 
CMD_LAST_PULSE_AND_TEST, b00001000, b00000000, 
CMD_LAST_PULSE_AND_TEST, b00001100, b00000000, 
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
CMD_SET_ALL_AND_TEST, b00101101, b01010010, b01010010, b00100101, 
CMD_SET_ALL_AND_TEST, b00001000, b00000000, b01010010, b00100101, 
CMD_SET_ALL_AND_TEST, b00101001, b00010000, b01010010, b00100101, 
CMD_SET_ALL_AND_TEST, b00001100, b01000010, b01010010, b00100101, 
CMD_END };
