MrDemonid/IC-Logic-Tester/Source/TOOLS/LCD/TTLDATA.H

const char tlab0000[] = { // ÈÏ3(181)
CMD_INIT_24|FL_OC, b11111111, b00001000, b11111110, 
CMD_SET_ALL_AND_TEST, b01001000, b00000000, b00000000, b00000000, b10000000, b00000000, 
CMD_SET_ALL_AND_TEST, b01001001, b00000000, b01101110, b00000000, b10010010, b00000000, 
CMD_END };
const char tlab0001[] = { // ÀÏ16(643)
CMD_INIT_20, b11111111, b00000011, b00001100, 
CMD_SET_ALL_AND_TEST, b11111111, b00000001, b00000000, b00000000, b00000000, b00000000, 
CMD_SET_ALL_AND_TEST, b00000001, b00000000, b00000000, b00000000, b11111100, b00000011, 
CMD_SET_ALL_AND_TEST, b01010101, b00000001, b00000000, b00000000, b10101000, b00000010, 
CMD_SET_ALL_AND_TEST, b10101011, b00000000, b00000000, b00000000, b01010100, b00000001, 
CMD_SET_ALL_AND_TEST, b00000001, b00000001, b00000000, b00000000, b11111000, b00000011, 
CMD_SET_ALL_AND_TEST, b10000001, b00000000, b00000000, b00000000, b11110100, b00000011, 
CMD_SET_ALL_AND_TEST, b01000001, b00000000, b00000000, b00000000, b11101100, b00000011, 
CMD_SET_ALL_AND_TEST, b00100001, b00000000, b00000000, b00000000, b11011100, b00000011, 
CMD_SET_ALL_AND_TEST, b00010001, b00000000, b00000000, b00000000, b10111100, b00000011, 
CMD_SET_ALL_AND_TEST, b00001001, b00000000, b00000000, b00000000, b01111100, b00000011, 
CMD_SET_ALL_AND_TEST, b00000101, b00000000, b00000000, b00000000, b11111100, b00000010, 
CMD_SET_ALL_AND_TEST, b00000011, b00000000, b00000000, b00000000, b11111100, b00000001, 
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
CMD_SET_ALL_AND_TEST, b00000000, b11110100, b00000011, b01111110, b00000001, b00000000, 
CMD_SET_ALL_AND_TEST, b00000000, b11101100, b00000011, b10111110, b00000001, b00000000, 
CMD_SET_ALL_AND_TEST, b00000000, b11011100, b00000011, b11011110, b00000001, b00000000,
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
