MrDemonid/IC-Logic-Tester/Source/TOOLS/LCD/8X12.H

#define FONT_WIDTH  8
#define FONT_HEIGHT 12
const char Fnt8x12[] = {
    0x00,0x00,0x00,0x00,0x00,0x00,0x00,0x00,0x00,0x00,0x00,0x00,    // code 0x20 for char
    0x30,0x78,0x78,0x78,0x30,0x30,0x30,0x00,0x30,0x30,0x00,0x00,    // code 0x21 for char !
    0x66,0x66,0x22,0x22,0x00,0x00,0x00,0x00,0x00,0x00,0x00,0x00,    // code 0x22 for char "
    0x07,0x08,0xFF,0x80,0x88,0x9F,0x88,0x80,0xFF,0x3F,0x00,0x00,    // code 0x23 for char #
    0xF0,0x08,0xFC,0x04,0x26,0xE6,0x06,0x06,0xFE,0xFE,0x00,0x00,    // code 0x24 for char $
    0x00,0x3E,0x40,0x40,0x3E,0x00,0x7E,0x12,0x12,0x0C,0x00,0x00,    // code 0x25 for char %
    0x38,0x6C,0x6C,0x38,0x30,0x76,0xDC,0xCC,0xCC,0x76,0x00,0x00,    // code 0x26 for char &
    0x30,0x30,0x30,0x60,0x00,0x00,0x00,0x00,0x00,0x00,0x00,0x00,    // code 0x27 for char '
    0x0C,0x18,0x30,0x30,0x30,0x30,0x30,0x30,0x18,0x0C,0x00,0x00,    // code 0x28 for char (
    0x30,0x18,0x0C,0x0C,0x0C,0x0C,0x0C,0x0C,0x18,0x30,0x00,0x00,    // code 0x29 for char )
    0x00,0x00,0x00,0x66,0x3C,0xFF,0x3C,0x66,0x00,0x00,0x00,0x00,    // code 0x2A for char *
    0x00,0x00,0x00,0x18,0x18,0x7E,0x18,0x18,0x00,0x00,0x00,0x00,    // code 0x2B for char +
    0x00,0x00,0x00,0x00,0x00,0x00,0x00,0x00,0x18,0x18,0x18,0x30,    // code 0x2C for char ,
    0x00,0x00,0x00,0x00,0x00,0xFE,0x00,0x00,0x00,0x00,0x00,0x00,    // code 0x2D for char -
    0x00,0x00,0x00,0x00,0x00,0x00,0x00,0x00,0x18,0x18,0x00,0x00,    // code 0x2E for char .
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
    0xF0,0x60,0x60,0x60,0x7C,0x66,0x66,0x66,0x66,0xFC,0x00,0x00,    // code 0x9C for char œ
    0x7C,0xC6,0x06,0x26,0x3E,0x26,0x06,0x06,0xC6,0x7C,0x00,0x00,    // code 0x9D for char �
    0xCC,0xD6,0xD6,0xD6,0xF6,0xD6,0xD6,0xD6,0xD6,0xCC,0x00,0x00,    // code 0x9E for char ž
    0x3E,0x66,0x66,0x66,0x3E,0x3E,0x66,0x66,0x66,0xC6,0x00,0x00     // code 0x9F for char Ÿ
};
