MrDemonid/IC-Logic-Tester/Source/TOOLS/LCD/BIN.H

// --- Binary table -----------
#define  b00000000    0
#define  b00000001    1
#define  b00000010    2
#define  b00000011    3
#define  b00000100    4
#define  b00000101    5
#define  b00000110    6
#define  b00000111    7
#define  b00001000    8
#define  b00001001    9
#define  b00001010   10
#define  b00001011   11
#define  b00001100   12
#define  b00001101   13
#define  b00001110   14
#define  b00001111   15
#define  b00010000   16
#define  b00010001   17
#define  b00010010   18
#define  b00010011   19
#define  b00010100   20
#define  b00010101   21
#define  b00010110   22
#define  b00010111   23
#define  b00011000   24
#define  b00011001   25
#define  b00011010   26
#define  b00011011   27
#define  b00011100   28
#define  b00011101   29
#define  b00011110   30
#define  b00011111   31
#define  b00100000   32
#define  b00100001   33
#define  b00100010   34
#define  b00100011   35
#define  b00100100   36
#define  b00100101   37
#define  b00100110   38
#define  b00100111   39
#define  b00101000   40
#define  b00101001   41
#define  b00101010   42
#define  b00101011   43
#define  b00101100   44
#define  b00101101   45
#define  b00101110   46
#define  b00101111   47
#define  b00110000   48
#define  b00110001   49
#define  b00110010   50
#define  b00110011   51
#define  b00110100   52
#define  b00110101   53
#define  b00110110   54
#define  b00110111   55
#define  b00111000   56
#define  b00111001   57
#define  b00111010   58
#define  b00111011   59
#define  b00111100   60
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
#define  b11101100  236
#define  b11101101  237
#define  b11101110  238
#define  b11101111  239
#define  b11110000  240
#define  b11110001  241
#define  b11110010  242
#define  b11110011  243
#define  b11110100  244
#define  b11110101  245
#define  b11110110  246
#define  b11110111  247
#define  b11111000  248
#define  b11111001  249
#define  b11111010  250
#define  b11111011  251
#define  b11111100  252
#define  b11111101  253
#define  b11111110  254
#define  b11111111  255
