MrDemonid/IC-Logic-Tester/Source/TOOLS/LCD/514DATA.H

const char ilab0000[] = { // 514ÈÄ2
CMD_INIT_14_1|FL_OC, b00111111, b00100000, 
CMD_SET_ALL_AND_TEST, b00001000, b00000000, b11000000, b00011111, 
CMD_SET_TO_1, 3, 
CMD_TEST_ALL, b00000000, b00000000, 
CMD_SET_ALL_AND_TEST, b00000100, b00000000, b00000000, b00001000, 
CMD_SET_ALL_AND_TEST, b00010100, b00000000, b11000000, b00011100, 
CMD_SET_ALL_AND_TEST, b00000101, b00000000, b00000000, b00010001, 
CMD_SET_ALL_AND_TEST, b00010101, b00000000, b01000000, b00010000, 
CMD_SET_ALL_AND_TEST, b00000110, b00000000, b11000000, b00000100, 
CMD_SET_ALL_AND_TEST, b00010110, b00000000, b01000000, b00000010, 
CMD_SET_ALL_AND_TEST, b00000111, b00000000, b00000000, b00000010, 
CMD_SET_ALL_AND_TEST, b00010111, b00000000, b11000000, b00011000, 
CMD_SET_ALL_AND_TEST, b00011100, b00000000, b01000000, b00000000, 
CMD_SET_ALL_AND_TEST, b00001101, b00000000, b00000000, b00010111, 
CMD_SET_ALL_AND_TEST, b00011101, b00000000, b01000000, b00010110, 
CMD_SET_ALL_AND_TEST, b00001110, b00000000, b11000000, b00000101, 
CMD_SET_ALL_AND_TEST, b00011110, b00000000, b01000000, b00000011, 
CMD_SET_ALL_AND_TEST, b00001111, b00000000, b00000000, b00000111, 
CMD_SET_ALL_AND_TEST, b00011111, b00000000, b11000000, b00011111, 
CMD_END };
const char ilab0001[] = { // 514ÈÄ1
CMD_INIT_14_1, b00111111, b00100000, 
CMD_SET_ALL_AND_TEST, b00000100, b00000000, b11000000, b00010111, 
CMD_SET_ALL_AND_TEST, b00010100, b00000000, b00000000, b00000011, 
CMD_SET_ALL_AND_TEST, b00000101, b00000000, b11000000, b00001110, 
CMD_SET_ALL_AND_TEST, b00010101, b00000000, b10000000, b00001111, 
CMD_SET_ALL_AND_TEST, b00000110, b00000000, b00000000, b00011011, 
CMD_SET_ALL_AND_TEST, b00010110, b00000000, b10000000, b00011101, 
CMD_SET_ALL_AND_TEST, b00000111, b00000000, b11000000, b00011101, 
CMD_SET_ALL_AND_TEST, b00010111, b00000000, b00000000, b00000111, 
CMD_SET_ALL_AND_TEST, b00001100, b00000000, b11000000, b00011111, 
CMD_SET_ALL_AND_TEST, b00011100, b00000000, b10000000, b00011111, 
CMD_SET_ALL_AND_TEST, b00001101, b00000000, b11000000, b00001000, 
CMD_SET_ALL_AND_TEST, b00011101, b00000000, b10000000, b00001001, 
CMD_SET_ALL_AND_TEST, b00001110, b00000000, b00000000, b00011010, 
CMD_SET_ALL_AND_TEST, b00011110, b00000000, b10000000, b00011100, 
CMD_SET_ALL_AND_TEST, b00001111, b00000000, b11000000, b00011000, 
CMD_SET_ALL_AND_TEST, b00011111, b00000000, b00000000, b00000000, 
CMD_END };
