MrDemonid/IC-Logic-Tester/Source/TOOLS/LCD/514MENU.H

#define ilen514    3
const char * const ilab514[] = { 0,ilab0001,ilab0000 };
const char * const iitem514[] = { "#$","514ÈÄ1","514ÈÄ2" };
const MENU mnu514 = { iitem514, 0x80, ilen514, (MENU **) ilab514  };
