MrDemonid/IC-Logic-Tester/Source/TOOLS/LCD/58XMENU.H

#define xlen58    8
const char * const xlab58[] = { 0,xlab0001,xlab0000,xlab0003,xlab0002,xlab0006,xlab0005,xlab0004 };
const char * const xitem58[] = { "#$","580ÂÀ86","580ÂÀ87","580ÈÐ82","580ÈÐ83","589ÀÏ16","589ÀÏ26","589ÈÐ12" };
const MENU mnux58 = { xitem58, 0x80, xlen58, (MENU **) xlab58  };
